yuchamichami/yuPad43/docs/README.md

# yuPad43 資料

ガイドは[リポジトリのトップ](../README.md)へ移しました。
