yuchamichami/yuPad43/docs/images/yuPad43-mechanical.png

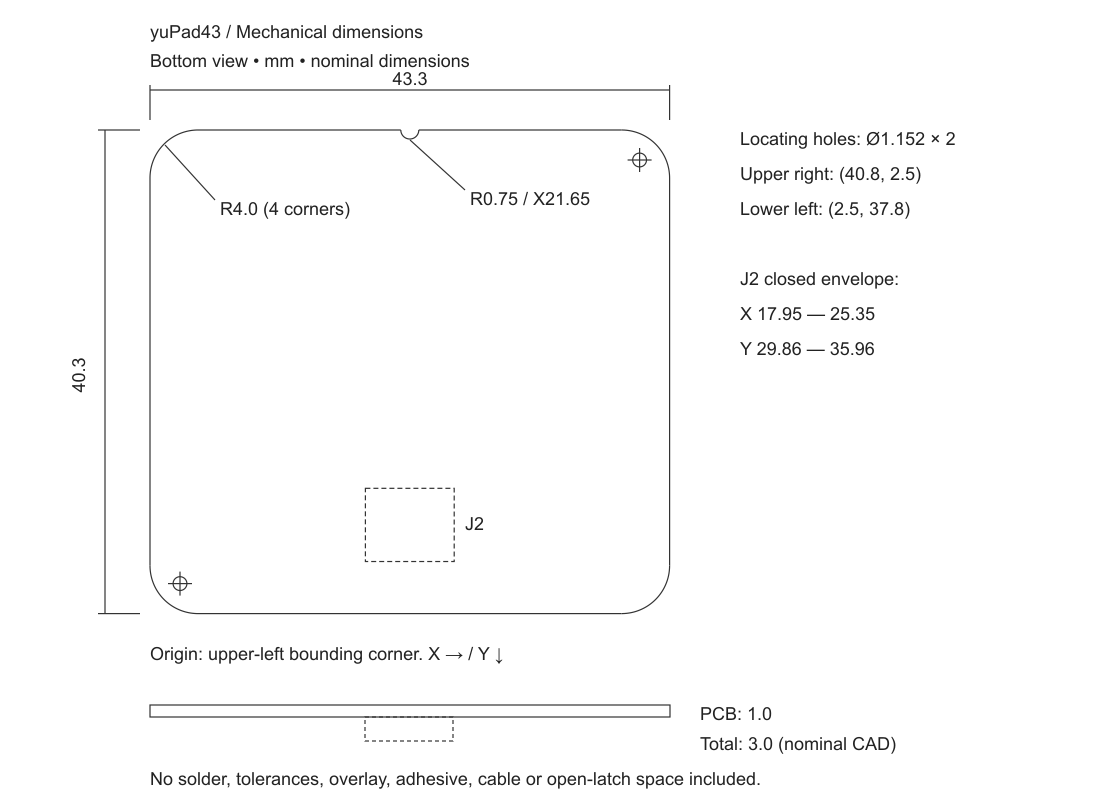
docs/images/yuPad43-mechanical.png
