yuchamichami/yuPad43/docs/images/yuPad43-underside.en.png

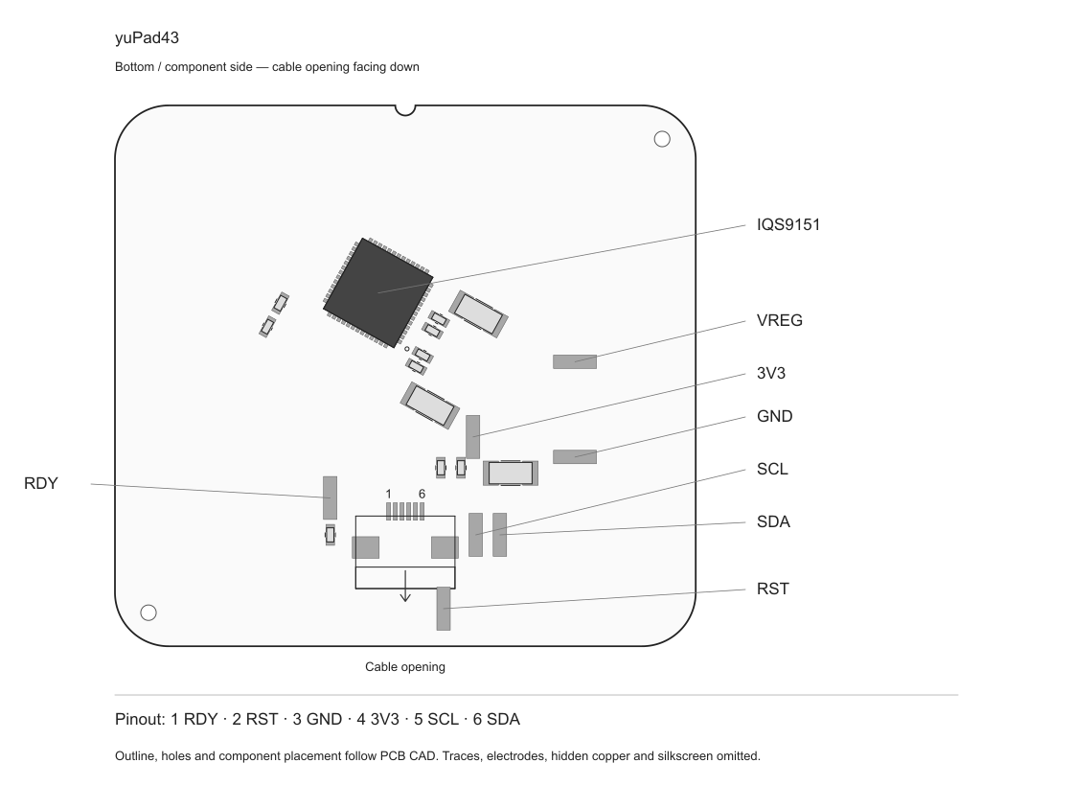
docs/images/yuPad43-underside.en.png
