yuchamichami/yuPad43/docs/mechanical/yuPad43-case-envelope.step

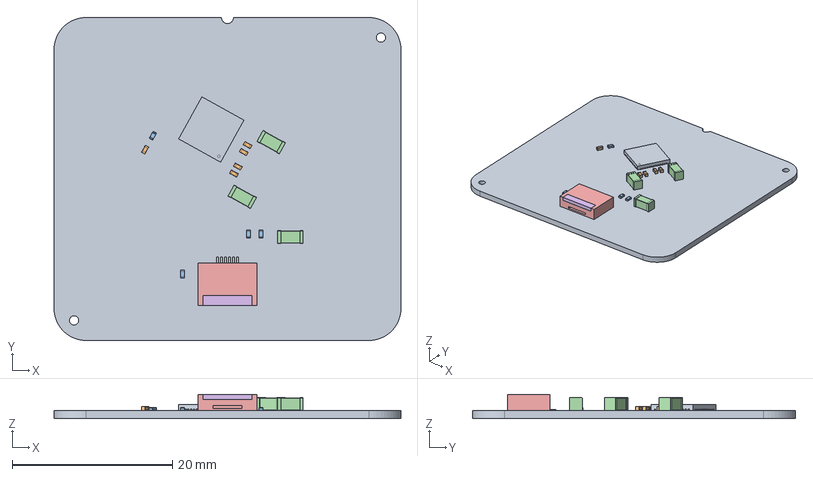
[picture p4: CAD file, 2026-11-12]
docs/mechanical/yuPad43-case-envelope.step
43.3 x 40.3 x 3.00 mm
PCB
C1
R3
C8
J2
U1
R4
C2
C3
C6
R2
C4
C7
C5
R1
