yuchamichami/yuPad43/(commit log)

2026-11-11 Add yuPad43 integration guide, firmware reference and case dimensions
    [register-writes.csv, yuPad43-case-envelope.step]
2026-11-11 Compact repository root and documentation entry page
    [register-writes.csv, yuPad43-case-envelope.step]
2026-11-11 Remove prototype history from user guide
2026-11-12 Simplify customer guide and ship tested cursor and scroll settings
    [register-writes.csv]
2026-11-12 Remove calibration caveat from customer introduction
2026-11-12 Present current scroll speed as standard level zero
2026-11-12 Replace mirrored component boxes with correctly oriented component STEP model
    [yuPad43-case-envelope.step]
